brainwagon/stevick-paul/fsp8_scaled.dxf

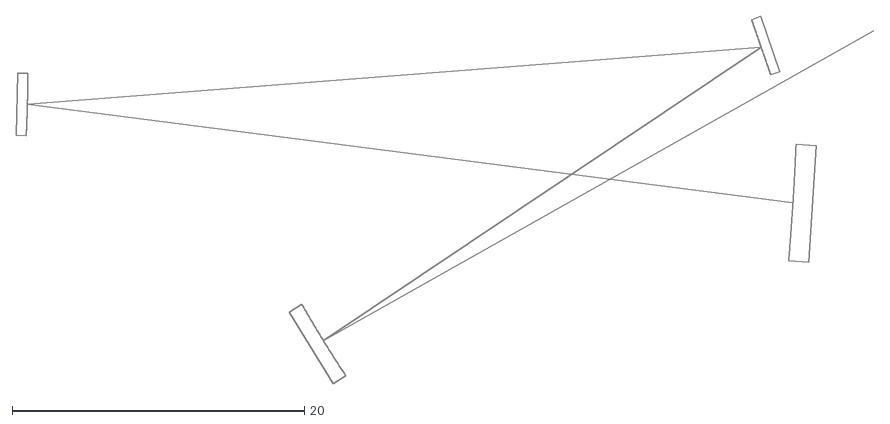
[picture p9: CAD file, 2026-10-10]
fsp8_scaled.dxf
58.7 x 25.1
