brainwagon/stevick-paul/fsp8_clear.dxf

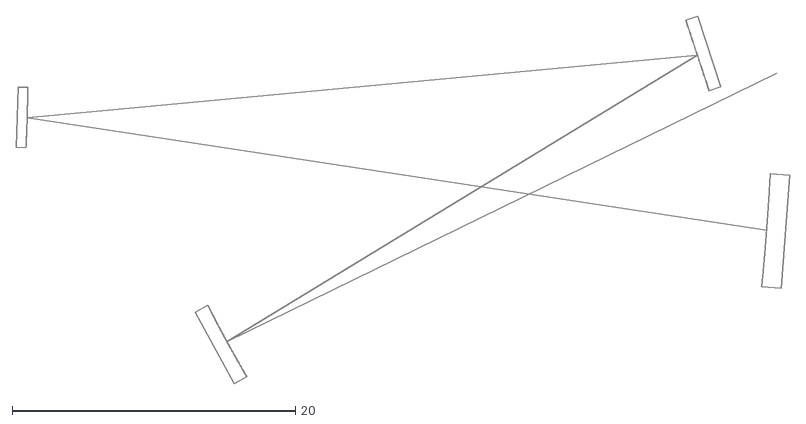
[picture p10: CAD file, 2026-10-10]
fsp8_clear.dxf
54.6 x 25.9
