brainwagon/stevick-paul/fsp_layout.dxf

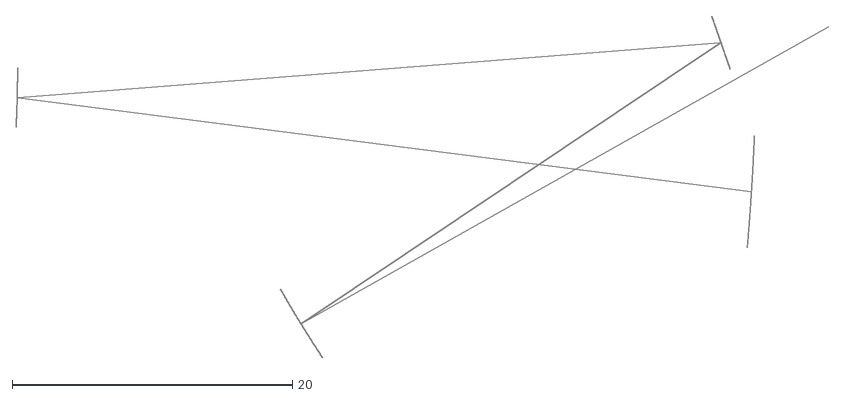
[picture p11: CAD file, 2026-10-10]
fsp_layout.dxf
58.0 x 24.4
