brainwagon/stevick-paul/sp_layout.dxf

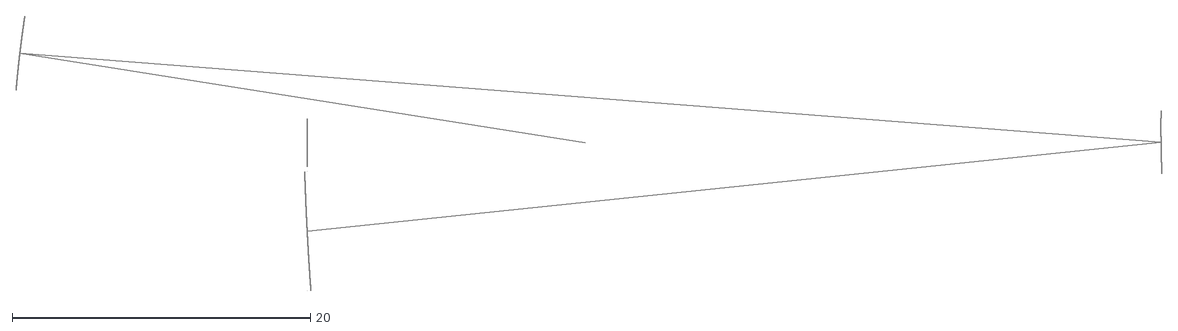
[picture p12: CAD file, 2026-10-10]
sp_layout.dxf
76.9 x 18.4
