brainwagon/stevick-paul/(commit log)

2026-10-10 Stevick-Paul telescope: design notes, build assessment, and exact 8" f/12 raytrace
    - DESIGN.md: collected facts, equations, history from the archived SEDS/AmSky manual
    - BUILD_NOTES.md: buildability assessment, f/12 vs f/15, risk register, why f/10+ only
    - TRACE.md: reconstructed exact geometry, verified diffraction-limited (RMS 0.77um)
    - sp_model.py / make_outputs.py: reproducible conic raytracer and figure generator
    - layout (png/svg/dxf), spot diagrams, and Airy-disk plots
    [sp_layout.dxf]
2026-10-10 Add README landing page and GitHub Pages (Jekyll) config
    - README.md: overview, exact raytrace result, embedded figures, contents table
    - _config.yml: cayman theme
    - index.md: home page rendering the README
2026-10-10 Fix diagonal placement: was obstructing the collimated beam
    The flat, placed at 0.72*e3 with a +/-1.4" extent, intruded ~0.5" into the
    collimated secondary->tertiary beam (63/613 rays blocked). Repositioned so the
    upper edge rides tangent to that beam and it still captures 100% of the
    converging cone (0 through-beam rays blocked). Regenerated layout/dxf/svg and
    documented the check in TRACE.md.
2026-10-10 Add FSP.md: folded Stevick-Paul construction guide with CAD drawings
    - FSP.md: what the FSP is, differences from the standard SP, exact raytraced
    prescriptions for 8" f/12 (A=0.45) and Novack's 6" f/10, construction sequence,
    folding-flat placement, and trade-offs
    - fsp_outputs.py: generates the FSP figures (uses sp_model.py)
    - fsp_layout.png/.svg/.dxf: dimensioned meridional CAD layout
    - fsp_folded.png: folded light-path schematic
    - README: link FSP.md from the contents table
    [fsp_layout.dxf]
2026-10-10 Fix folded Stevick-Paul layout
    [fsp_layout.dxf]
2026-10-10 Rebuild FSP to Novack's actual topology: flat between secondary and tertiary
    Novack's drawing and text put the folding flat in the collimated
    secondary->tertiary beam (P -> S -> flat -> T -> focus), not in the
    tertiary's converging cone. The fold also needs a larger primary tilt
    than the A=0.4 C table gives (2*T1 = 8.77 deg at f/10, C ~ 43.85).
    Add sp_model.build_fsp(), which reproduces every point of Novack's 6" f/10
    drawing to 0.01" from Stevick's equations, and rebuild the 8" f/12 by
    scaling it. Raytrace: 0.38 um RMS on-axis, no obstruction, minimum edge
    clearance 0.53" (flat vs returning cone). Figures and FSP.md regenerated.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
    [fsp_layout.dxf]
2026-10-10 FSP: model flat clearance with real glass and field; document two 8" layouts
    The folding flat clips the tertiary->focus cone once it is modelled as a
    solid blank (thickness = dia/6) and the field edge is traced; the previous
    check used a zero-thickness disc and on-axis rays only.
    - fsp_outputs.py: solid-disc vignetting/clearance over a 0.75" field,
    spots on the best-fit tilted image plane, flat close-up figure; fails if
    the clear-field layout obstructs a beam.
    - Two 8" f/12 layouts: A scaled from Novack (C=43.85, 4" flat, ~85%
    transmission at field edge) and B clear-field (C=52, +0.28" clearance,
    100%). Spot diagrams with Airy disk for both.
    - FSP.md: write up Novack's as-drawn fla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
    [fsp8_clear.dxf, fsp8_scaled.dxf]
